mrcabu166-dotcom/SolidCraft/microdry/output/png/rotor_iso.png

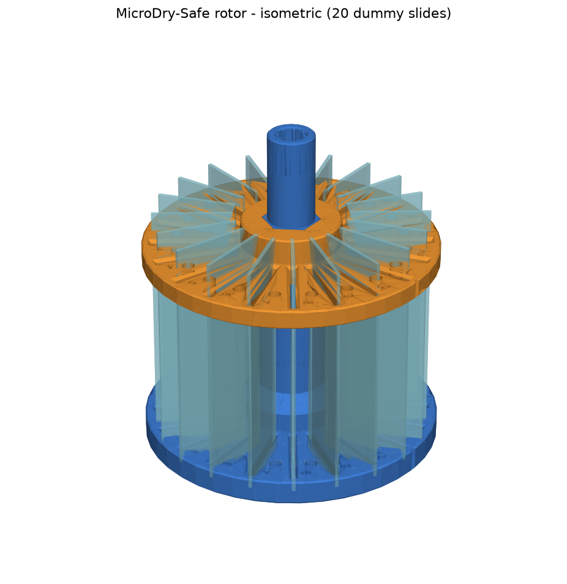
microdry/output/png/rotor_iso.png
