mrcabu166-dotcom/SolidCraft/microdry/output/png/rotor_section_in_jar.png

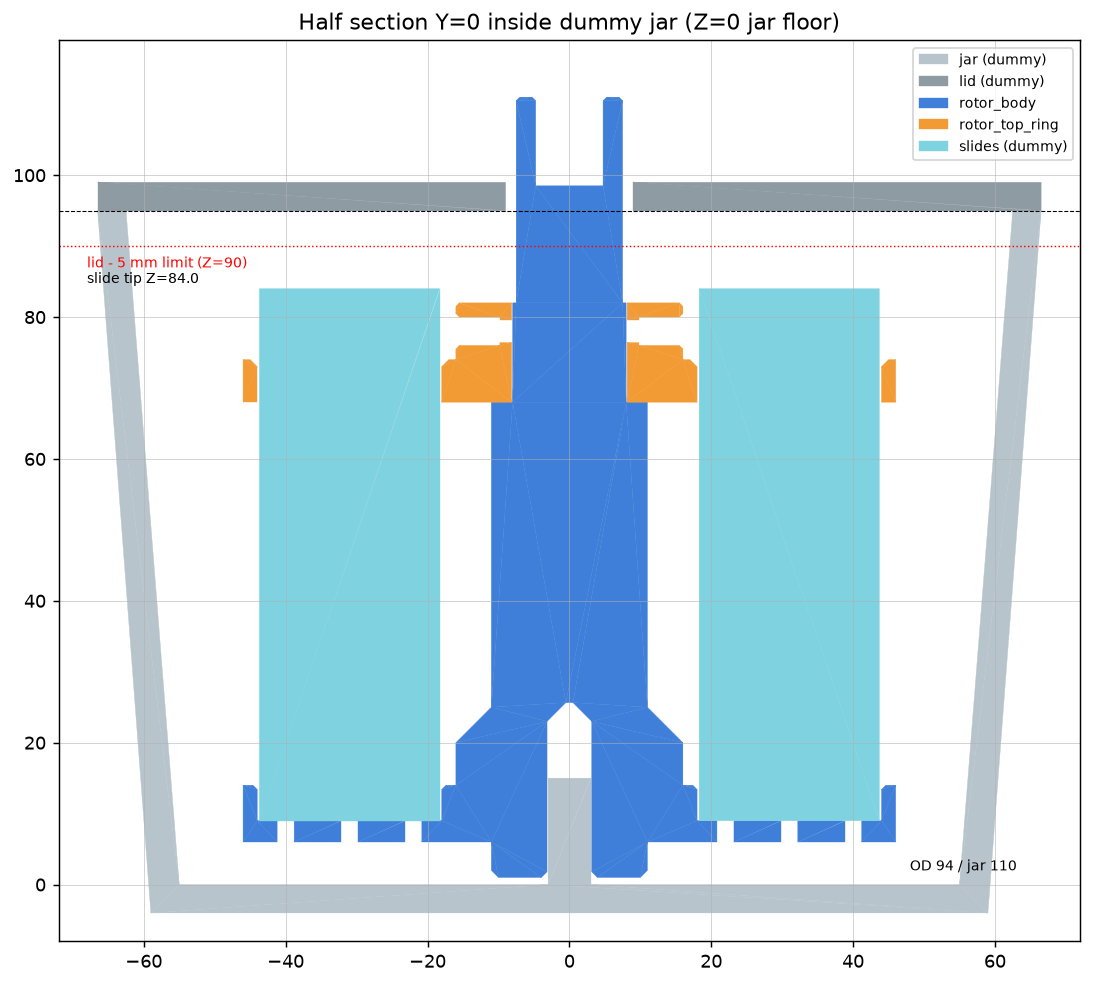
microdry/output/png/rotor_section_in_jar.png
