mrcabu166-dotcom/SolidCraft/microdry/output/png/rotor_top.png

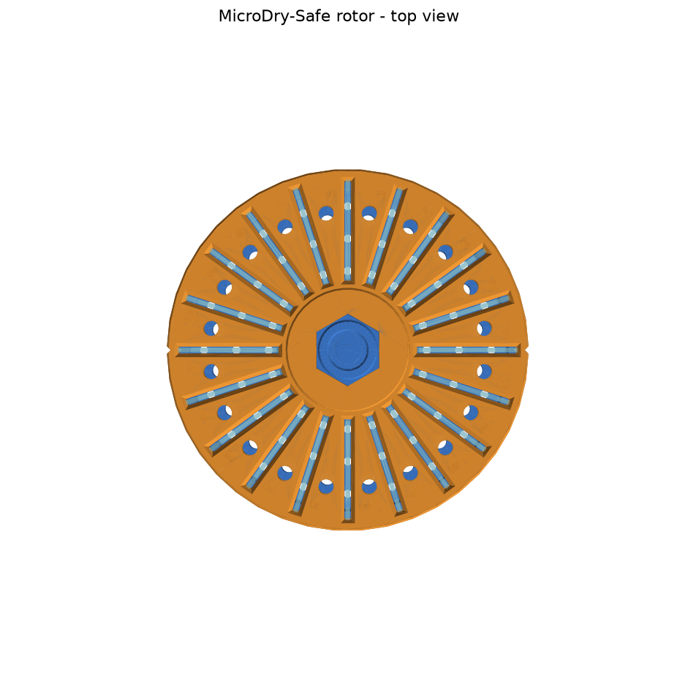
microdry/output/png/rotor_top.png
