mrcabu166-dotcom/SolidCraft/microdry/output/step/rotor_assembly.step

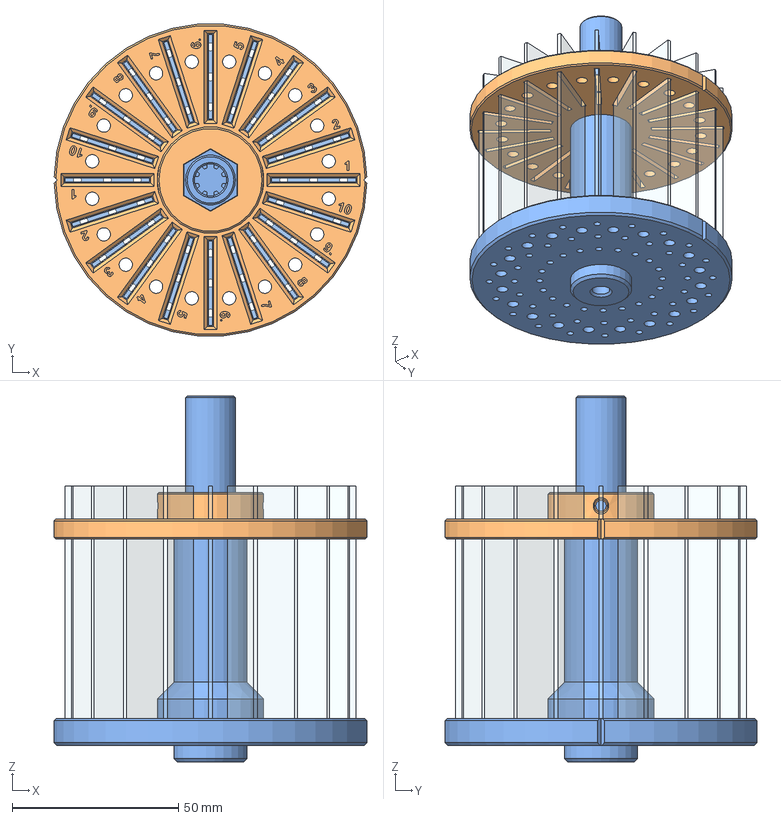
[picture p4: CAD file, 2026-10-15]
microdry/output/step/rotor_assembly.step
94.0 x 93.7 x 110.0 mm
rotor_body
rotor_top_ring
slide_01
slide_02
slide_03
slide_04
slide_05
slide_06
slide_07
slide_08
slide_09
slide_10
slide_11
slide_12
slide_13
slide_14
slide_15
slide_16
slide_17
slide_18
slide_19
slide_20
