mrcabu166-dotcom/SolidCraft/microdry/output/step/fit_test.step

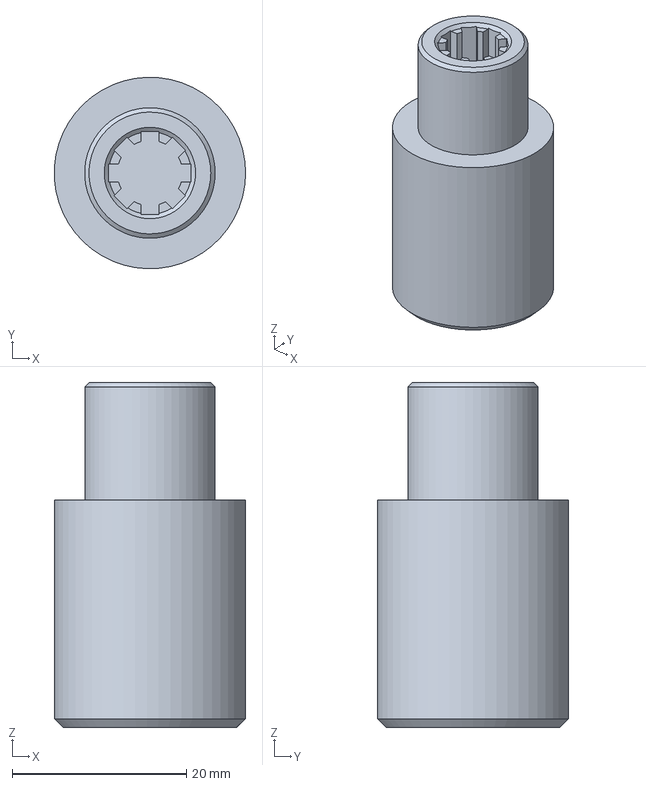
[picture p5: CAD file, 2026-10-15]
microdry/output/step/fit_test.step
22.0 x 22.0 x 39.6 mm
