mrcabu166-dotcom/SolidCraft/microdry/output/step/rotor_body.step

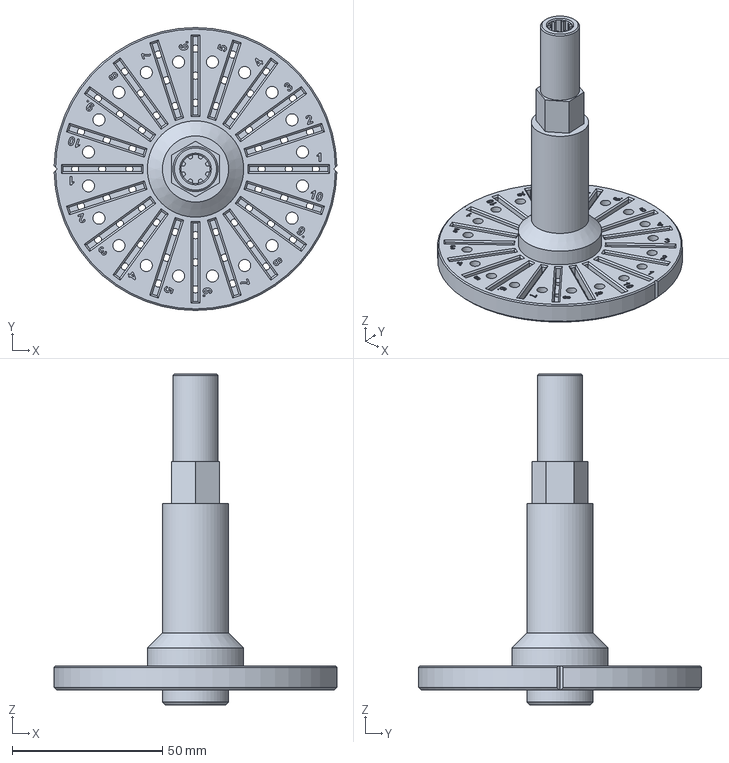
[picture p6: CAD file, 2026-10-15]
microdry/output/step/rotor_body.step
94.0 x 94.0 x 110.0 mm
