mrcabu166-dotcom/SolidCraft/microdry/output/step/rotor_top_ring.step

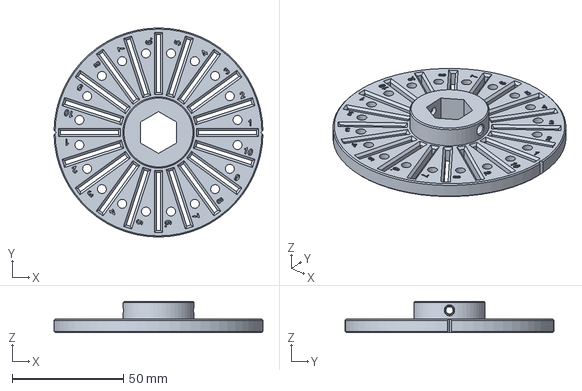
[picture p7: CAD file, 2026-10-15]
microdry/output/step/rotor_top_ring.step
94.0 x 94.0 x 14.0 mm
