mrcabu166-dotcom/SolidCraft/(list of files, cad)

Other CAD files:
microdry/output/stl/fit_test.stl
microdry/output/stl/rotor_body.stl
microdry/output/stl/rotor_top_ring.stl
